t2t-io/kicad-tt-library/README.md

# kicad-tt-library

KiCad libraries for those common parts/components used in T2T projects/products.
