t2t-io/kicad-tt-library/(commit log)

2020-03-31 add a relay RW-SS-112D symbol.
2020-04-07 add a 2X02 long connector.
2020-05-18 -set EMIFIL footprint -add SRS-1212 symbol and footprint.
2020-05-27 Add LED2000 symbol.
2020-05-29 TPS55340RTET symbol add a "GND"pin
2020-06-02 Add Moled connector.
2020-06-16 update library: -add TPS62135 symbol and footprint
2020-06-16 Add Cree PLCC8 symbol and footprint.
2020-06-20 -add cree CLO6A LED 3D model.
2020-07-14 -add Molex 037207503 footprint. -add HLSR32 footprint. -add HCMA1707 footprint. -add Blade footprint.
2020-07-28 update DRV8832 footprint and 3d model.
2020-07-29 add a GND pad for DRV8832.
2020-09-17 add STM32G031 symbol.
2020-11-17 -add 746x101 footprint.
2020-11-17 -fix footprint "TQFP-176_24x24mm_P0.5mm_ThermalPad8.07x7.33" ,"BI_Technologies_POT N6V"
2020-11-20 -add footprint Keystone4910_6.4mm.
2020-11-25 add BP104F footprint.
2020-11-26 -add stm32g031 symbol.
2020-11-26 add stm32G431x6 symbol.
2020-11-26 update STM32G431x6_x8_xB symbol.
2020-11-27 add footprint.
2020-12-01 add GS-SH-212T symbol & footprint.
2020-12-01 add SOT connector.
2020-12-07 assign a footprint to RI-STU-MRD2.
2020-12-09 add DC JACD & Blade connector 3D model.
2020-12-23 add 744290130 symbol , footprint and 3D model.
2020-12-23 add WE-LPCC-7448680200 symbol, footprint and 3D model.
2020-12-24 add Molex_35312-0460 footprint and 3D model.
2021-03-03 add 3D models for JST B2B/B3B/B8B connectors, OST S201/S261/S401 connectors, variable resistor and TI TMS320F28379S MCU
2021-03-17 add FT2232H-56 Mini-Module symbol and footprint.
2021-03-25 fix pin electrical type of symbolFT2232H-56_Mini-Module.
2021-05-01 added a footprint for SAMTEC_FTR-110-51-L-D-06
2021-05-14 add switch button: B3F-1000
2021-06-24 add SLR1200 footprint.
2021-06-25 update SLR1200 footprint.
2021-09-11 add KEMET relay
2021-09-27 add 1287-ST connector
2021-09-30 add PJS008-2003-1 symbol, footprint, 3Dmodel.
2021-10-06 add 110990030 footprint and 3D model.
2021-10-31 add Molex and TE connectors
2021-11-12 add SM10B-SRSS-TB.STEP add a 3D model dummy footprint.
2021-11-12 fix dummy.kicad_mode file path.
2021-11-13 add 3D CAD for SD card slot
2022-01-28 feat(3d): add JST/S2B-PH connector
2022-04-13 add some symbol and footprint
2022-04-13 add CB2 pin define symbol.
2022-04-14 add esp32 c3 symbol and footprint.
2022-04-25 add M.2 footprint update W25Q16JVSSIQ symbol.
2022-04-27 update CB2-CORE-STD by pretty-ize pin location
2022-04-27 add ws2812 symbol and footprint.
2022-05-03 add FSUSB30UMX symbol and footprint.
2022-05-23 fix and update keystone 1287 connector
2022-05-30 add m.2 connector.
2022-05-31 add usb-c and SMD switch.
2022-06-10 add ICM-42688-P symbol. add PCA9615 symbol. add vr20 footprint. addRJ45-8 3D. add jst S5B-PH-SM4 3D.
2022-06-15 fix USB-C footprint.
2022-06-15 add LDO 3D model and update footprint.
2022-06-16 fix rp2040 footprint.
2022-06-22 fix LED symbol and footprint.
2022-07-25 add footprint WE 7499511441
2022-09-21 add FT4232H-56Q-REEL footprint to lib
2022-10-17 add zigbee SMD footprint.
2022-12-27 add I3A4W005A150V-001-R symbol and footprint
2023-01-06 add usb c connector.
2023-02-20 add IZB03 footprint and symbol
2023-02-24 update footprint
2023-03-01 add Si1865DDL IC.
    add EHF-105-01-XX-D-SM connector.
2023-03-02 add EHF-125-01-XX-D-SM footprint
2023-03-03 add TFML-107-02-X-D-LC footprint and 3D.
2023-03-03 add PTB0143-2010BPA103 symbol ,footprint and 3D model.
    add TCST1300 symbol ,footprint and 3D model.
2023-03-06 fix TCST1300 footprint.
2023-03-07 fix footprint.
2023-03-08 fix footprint pin "number"
2023-03-09 add PTA6043 footprint.
2023-03-09 add FTSH-105-01-F-DV-K-A footprint.
2023-03-10 add buzzer footprint.
2023-03-21 add FTSH-113-01-L-DV-K-P-TR footprint & step.
2023-03-21 fix SAMTEC_FTSH-113-01-L-DV-K-P-TR footprint.
2023-03-24 add LC2510 3d model and footprint.
2023-04-04 add THN_30-2412WI symbol ,footprint and 3D model.
2023-04-07 fix footprint "footprint type"
2023-05-17 fix PTB01432010BPA103 footprint.
2023-05-18 fix IZB03 footprint.
2023-05-18 add TFM-107-02-L-D-WT footprint and 3D model.
2023-05-23 add T4140012121000 footprint.
2023-05-23 add T4141012081000 footprint.
2023-05-23 add M12 connectors for PCB DIP mounting
2023-06-09 fix SAMTEC_TFM-107-02-L-D-WT footprint.
2023-09-13 add and update I3A4W005A150V-001-R footprint
2023-11-16 add a PTB01432010BPB103 footprint
2023-12-08 update SAMTEC_TFM-107-02-L-D-WT footprint.
2024-07-02 udpate 5190TR footprint.
2024-11-13 update change SATA position hole size.
2024-11-13 updata SATA connector.
